den4ik86/Sodar_generator/Schematic_FNCH_2026-05-06.png

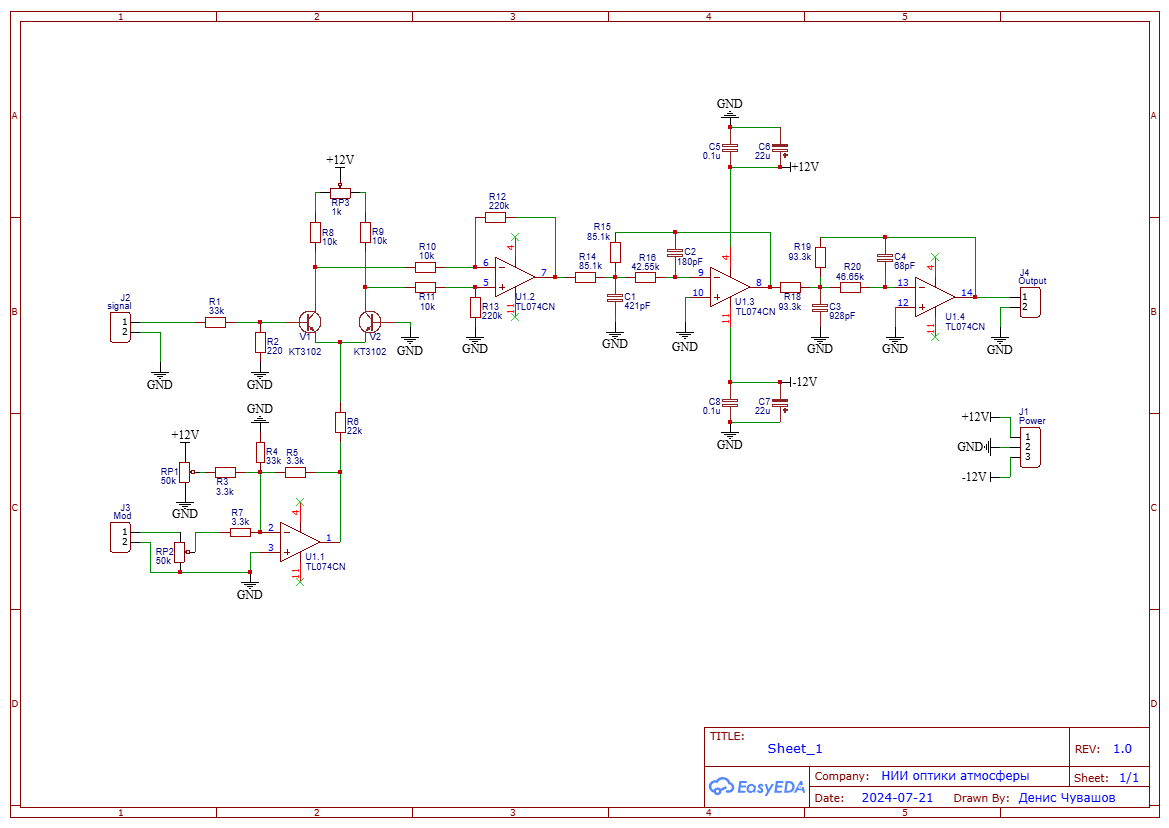
Schematic_FNCH_2026-05-06.png
