den4ik86/Sodar_generator/Schematic_modulator_2026-05-06.png

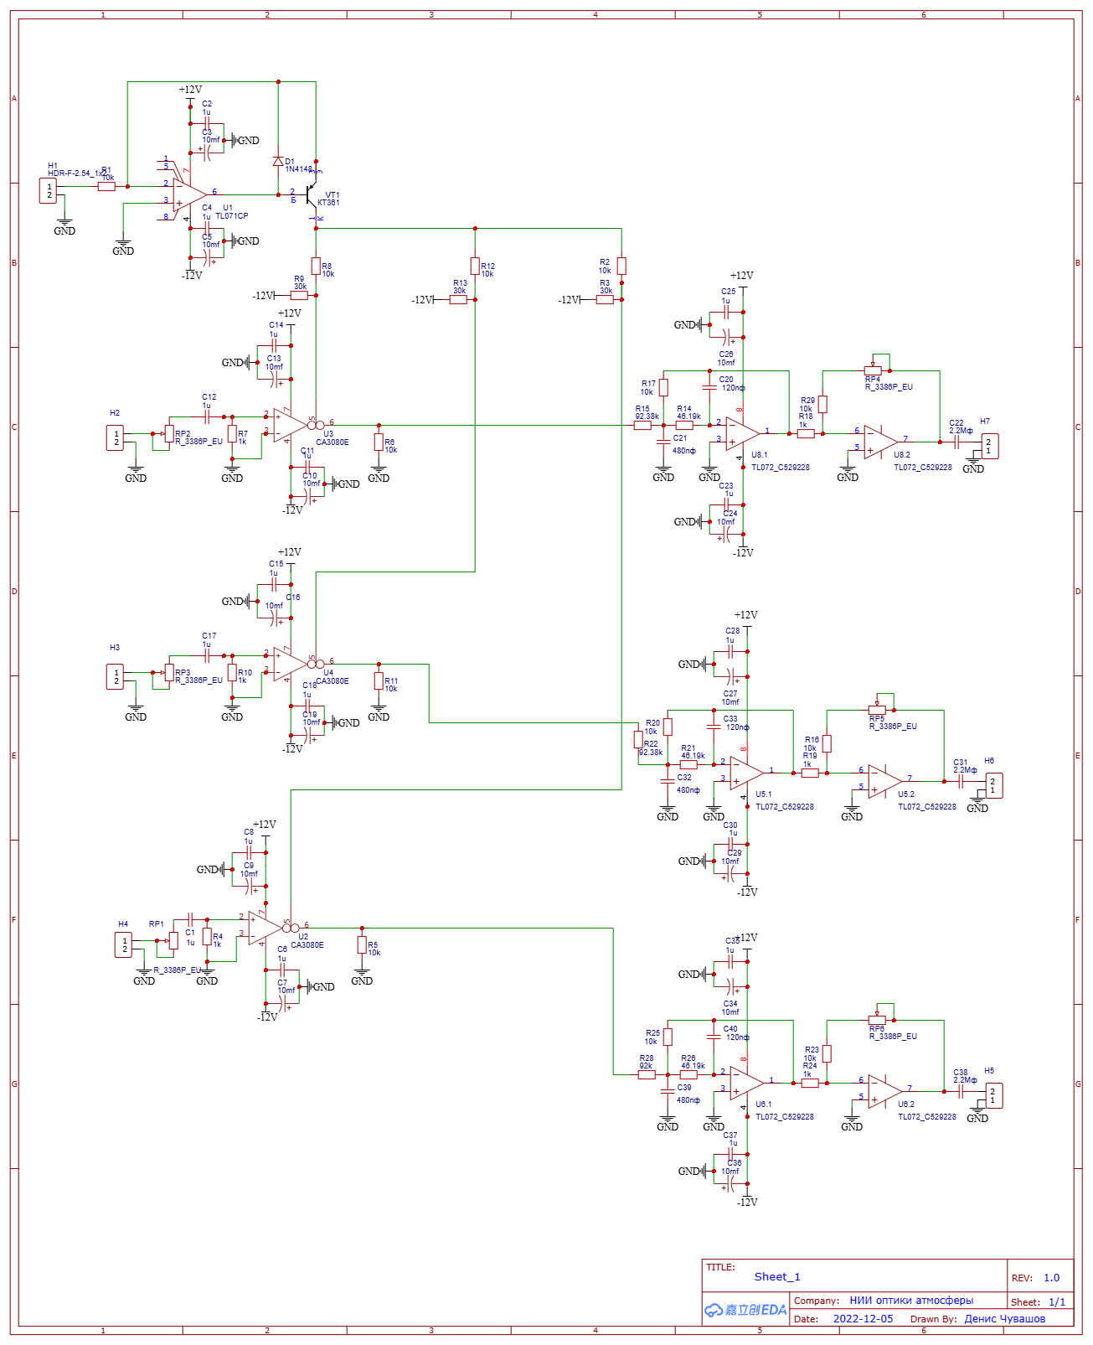
Schematic_modulator_2026-05-06.png
